neilenns/Collins-FMS-3000/reference.png

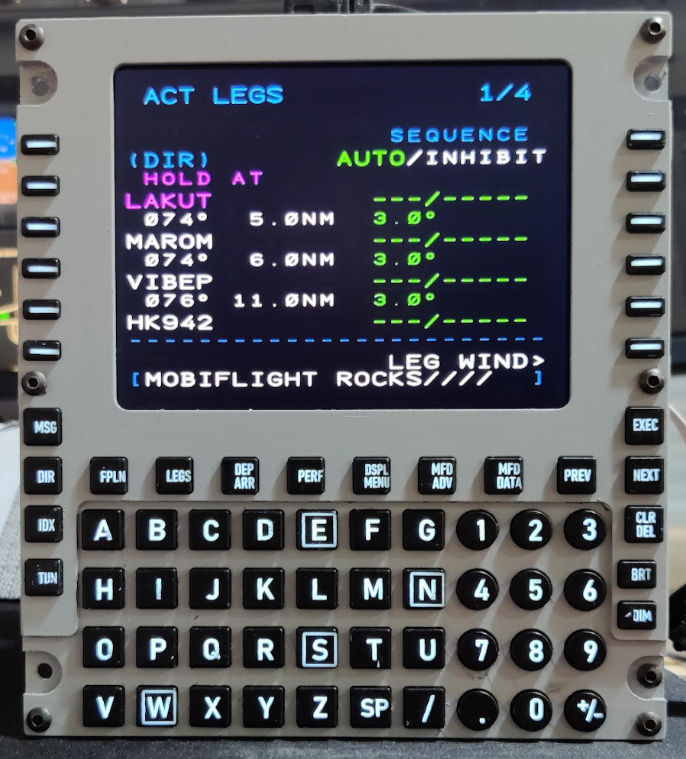
reference.png
