neilenns/Collins-FMS-3000/Sim reference.png

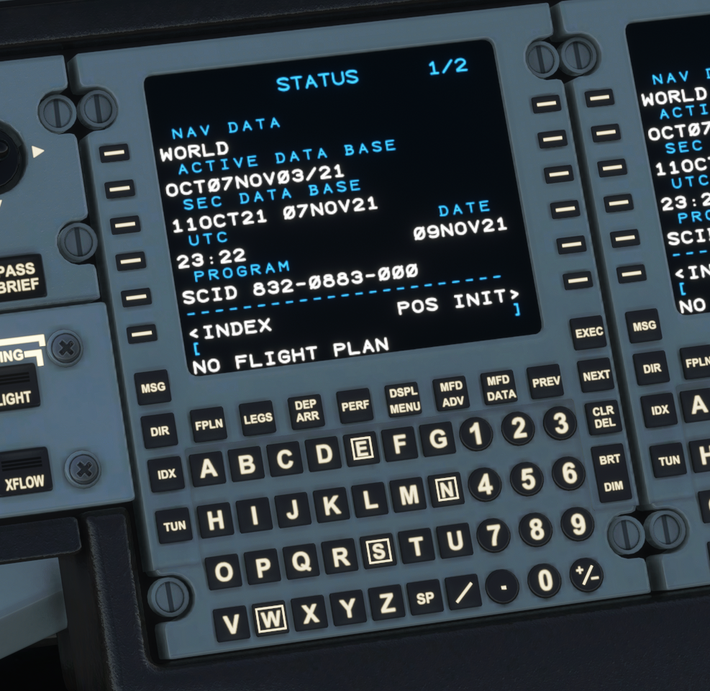
Sim reference.png
