neilenns/Collins-FMS-3000/README.md

# Collins-FMS-3000
PCB for a replica Collins FMS-3000 to use with MobiFlight
