neilenns/Collins-FMS-3000/3D Models/UE25BE5510H--3DModel-STEP-533217.STEP

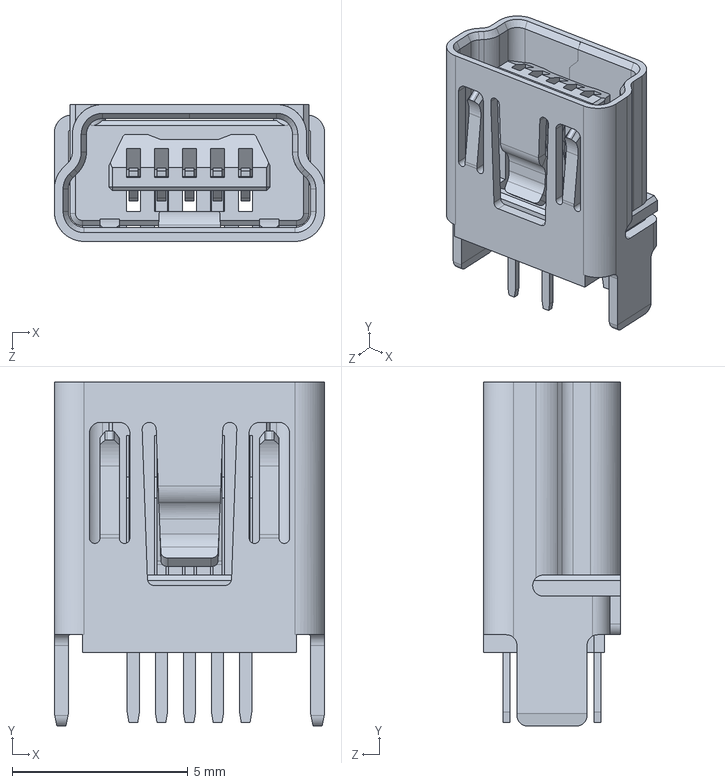
[picture p3: CAD file, 2022-11-02]
3D Models/UE25BE5510H--3DModel-STEP-533217.STEP
7.70 x 9.80 x 3.90 mm
