neilenns/Collins-FMS-3000/Key caps/Board mount bar.stl

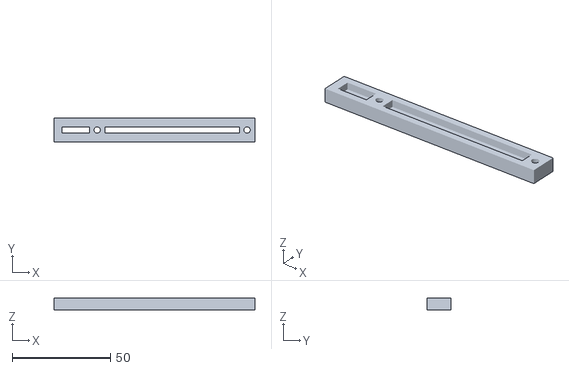
[picture p4: CAD file, 2022-12-11]
Key caps/Board mount bar.stl
102.1 x 12.0 x 6.00
