neilenns/Collins-FMS-3000/3D Models/6x6 LED button.step

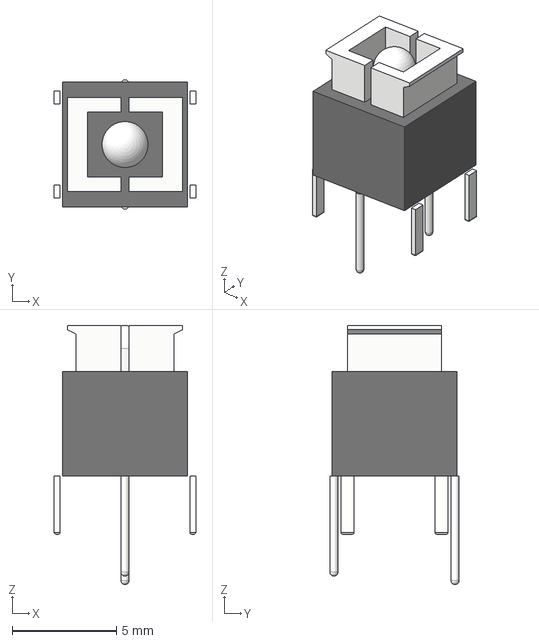
[picture p5: CAD file, 2022-11-02]
3D Models/6x6 LED button.step
6.78 x 6.20 x 12.4 mm
