neilenns/Collins-FMS-3000/Key caps/Screen frame.stl

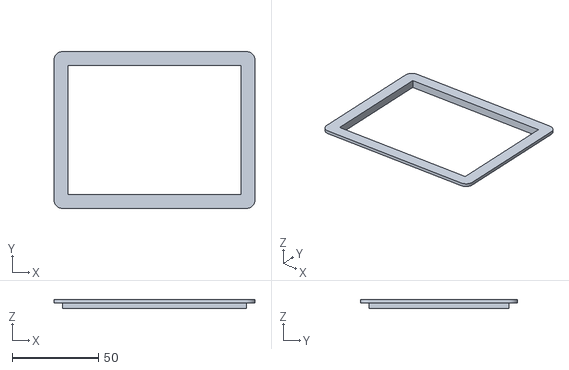
[picture p6: CAD file, 2022-12-11]
Key caps/Screen frame.stl
116.8 x 91.2 x 5.00
