neilenns/Collins-FMS-3000/Key caps/Panel.stl

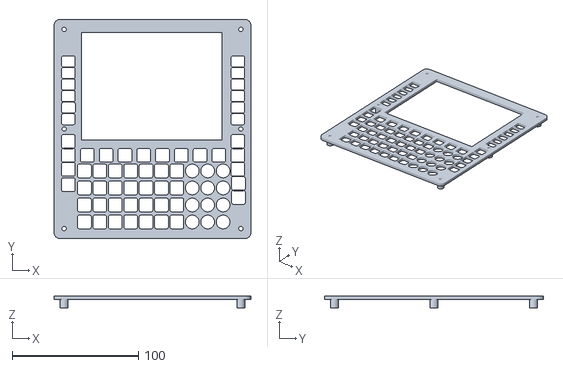
[picture p7: CAD file, 2022-12-11]
Key caps/Panel.stl
155.9 x 173.6 x 9.80
