neilenns/Collins-FMS-3000/Key caps/Board mount bracket.stl

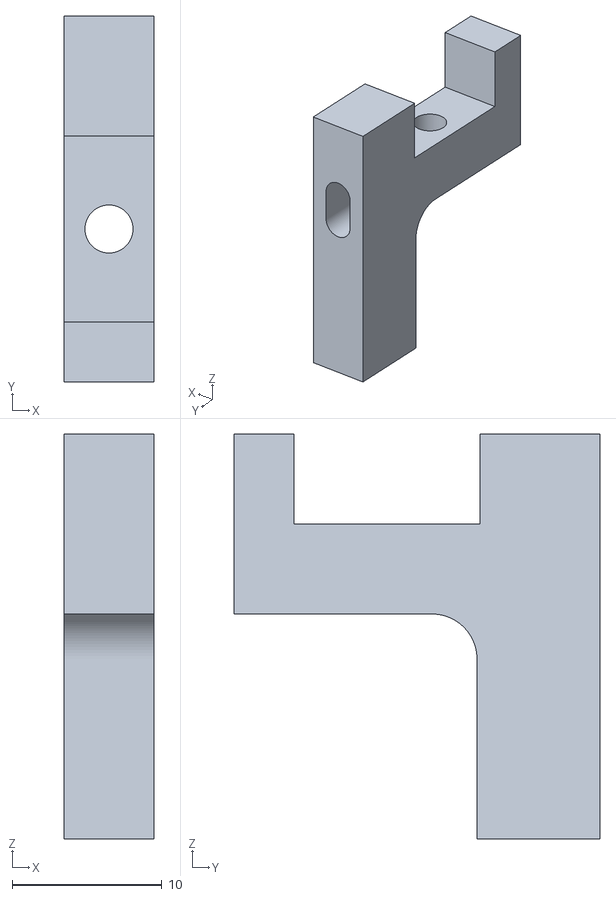
[picture p8: CAD file, 2022-12-11]
Key caps/Board mount bracket.stl
6.00 x 24.4 x 27.0
