neilenns/Collins-FMS-3000/Key caps/Blank round.stl

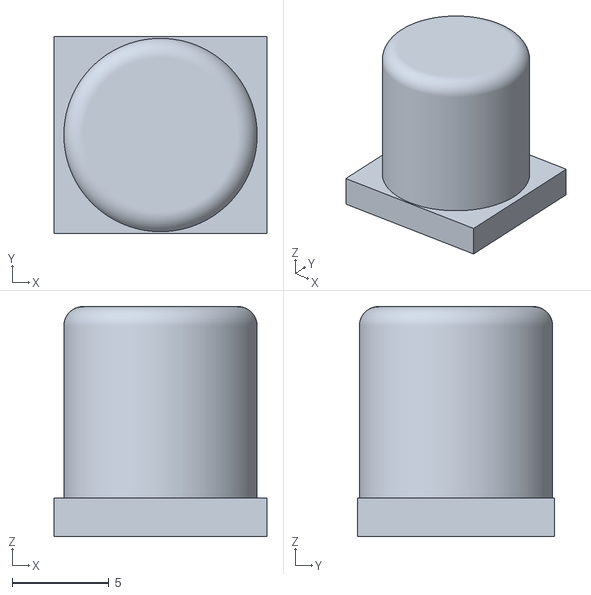
[picture p9: CAD file, 2022-11-27]
Key caps/Blank round.stl
11.0 x 10.2 x 11.9
