neilenns/Collins-FMS-3000/Key caps/Blank rectangle.stl

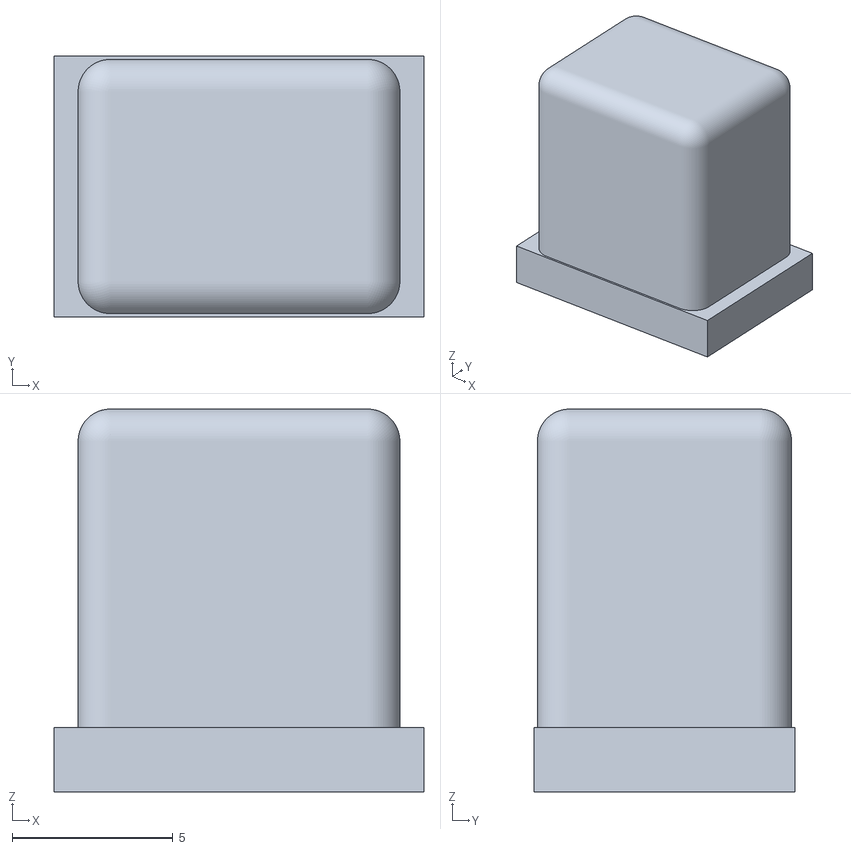
[picture p10: CAD file, 2022-11-27]
Key caps/Blank rectangle.stl
11.5 x 8.10 x 11.9
