neilenns/Collins-FMS-3000/Key caps/Blank square.stl

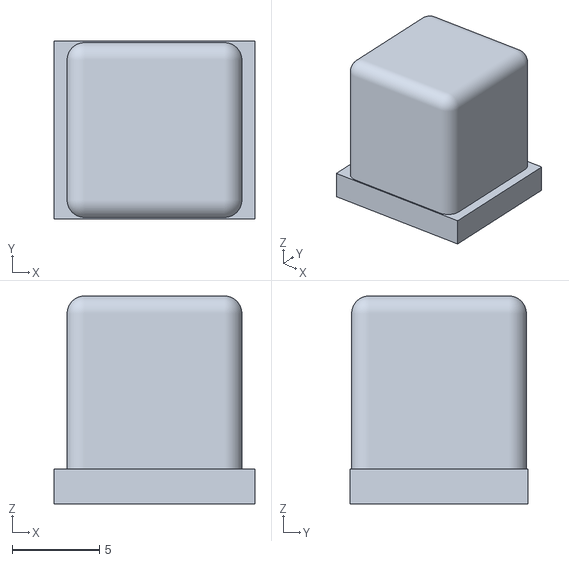
[picture p11: CAD file, 2022-11-27]
Key caps/Blank square.stl
11.5 x 10.2 x 11.9
