neilenns/Collins-FMS-3000/Collins-FMS-3000.kicad_pcb

## KiCad design Collins-FMS-3000.kicad_pcb (2023-01-21)

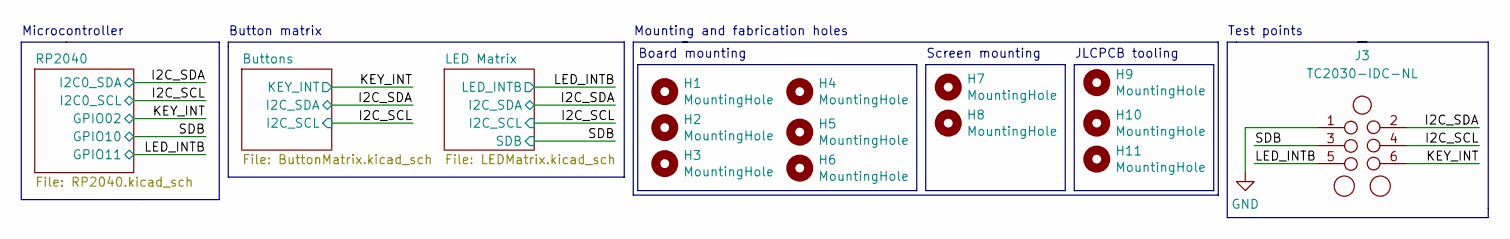
[picture p12: schematic Collins-FMS-3000.kicad_sch, Collins FMS 3000]

Parts:
H1, H2, H3, H4, H5, H6, H7, H8: MountingHole; MountingHole_3.2mm_M3
H9, H10, H11: MountingHole; JLCPCB_Tooling_Hole
J3: TC2030-IDC-NL; Tag-Connect_TC2030-IDC-NL_2x03_P1.27mm_Vertical

Connections:
/I2C_SCL: J3.4; also elsewhere on the board
/I2C_SDA: J3.2; also elsewhere on the board
/KEY_INT: J3.6; also elsewhere on the board
/LED_INTB: J3.5; also elsewhere on the board
/SDB: J3.3; also elsewhere on the board
GND: J3.1; also elsewhere on the board

Notes on the sheet:
Test points
Button matrix
Board mounting
Screen mounting
Microcontroller
Mounting and fabrication holes
JLCPCB tooling

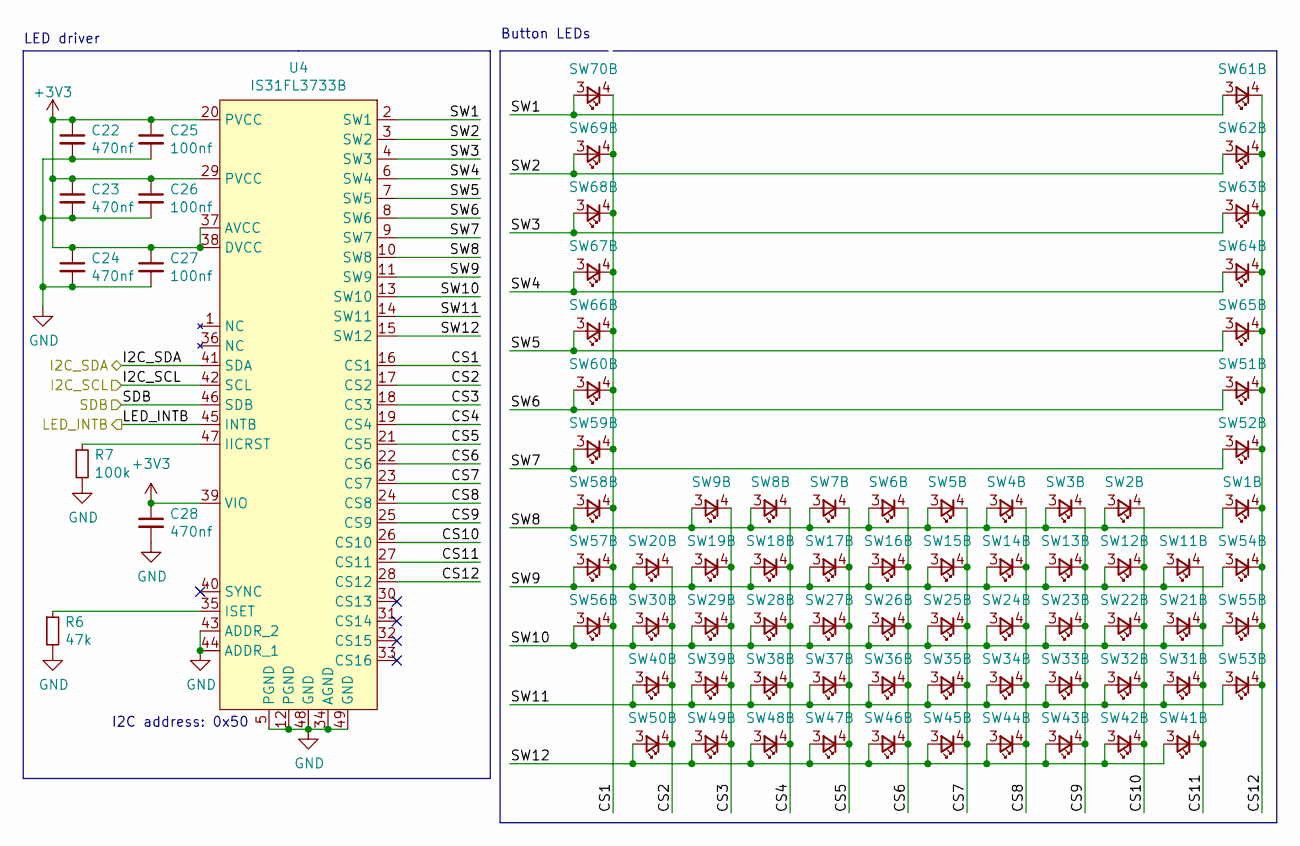
[picture p13: schematic LEDMatrix.kicad_sch, Collins FMS 3000]

Parts:
C22, C23, C24, C28: 470nf; Perfect_0402; MPN - JLCPCB C47339; JLC 0402
C25, C26, C27: 100nf; Perfect_0402; MPN - JLCPCB C1525; JLC 0402
R6: 47k; Perfect_0402; MPN - JLCPCB C25792; JLC 0402
R7: 100k; R_0603_1608Metric; MPN - JLCPCB C25803; JLC 0603
SW1, SW2, SW3, SW4, SW5, SW6, SW7, SW8, SW9, SW11, SW12, SW13, SW14, SW15, SW16, SW17, SW18, SW19, SW20, SW21, SW22, SW23, SW24, SW25, SW26, SW27, SW28, SW29, SW30, SW31, SW32, SW33, SW34, SW35, SW36, SW37, SW38, SW39, SW40, SW41, SW42, SW43, SW44, SW45, SW46, SW47, SW48, SW49, SW50, SW51, SW52, SW53, SW54, SW55, SW56, SW57, SW58, SW59, SW60, SW61, SW62, SW63, SW64, SW65, SW66, SW67, SW68, SW69, SW70: SW_Push_LED; SW_PUSH_LED_THT
U4: IS31FL3733B; TQFP-48-1EP_7x7mm_P0.5mm_EP5x5mm_ThermalVias

Connections:
+3V3: C22.1, C23.1, C24.1, C25.1, C26.1, C27.1, C28.1, U4.20 (PVCC), U4.29 (PVCC), U4.37 (AVCC), U4.38 (DVCC), U4.39 (VIO); also elsewhere on the board
/I2C_SCL: U4.42 (SCL); also elsewhere on the board
/I2C_SDA: U4.41 (SDA); also elsewhere on the board
/LED Matrix/CS1: SW56.4, SW57.4, SW58.4, SW59.4, SW60.4, SW66.4, SW67.4, SW68.4, SW69.4, SW70.4, U4.16 (CS1)
/LED Matrix/CS2: SW20.4, SW30.4, SW40.4, SW50.4, U4.17 (CS2)
/LED Matrix/CS3: SW9.4, SW19.4, SW29.4, SW39.4, SW49.4, U4.18 (CS3)
/LED Matrix/CS4: SW8.4, SW18.4, SW28.4, SW38.4, SW48.4, U4.19 (CS4)
/LED Matrix/CS5: SW7.4, SW17.4, SW27.4, SW37.4, SW47.4, U4.21 (CS5)
/LED Matrix/CS6: SW6.4, SW16.4, SW26.4, SW36.4, SW46.4, U4.22 (CS6)
/LED Matrix/CS7: SW5.4, SW15.4, SW25.4, SW35.4, SW45.4, U4.23 (CS7)
/LED Matrix/CS8: SW4.4, SW14.4, SW24.4, SW34.4, SW44.4, U4.24 (CS8)
/LED Matrix/CS9: SW3.4, SW13.4, SW23.4, SW33.4, SW43.4, U4.25 (CS9)
/LED Matrix/CS10: SW2.4, SW12.4, SW22.4, SW32.4, SW42.4, U4.26 (CS10)
/LED Matrix/CS11: SW11.4, SW21.4, SW31.4, SW41.4, U4.27 (CS11)
/LED Matrix/CS12: SW1.4, SW51.4, SW52.4, SW53.4, SW54.4, SW55.4, SW61.4, SW62.4, SW63.4, SW64.4, SW65.4, U4.28 (CS12)
/LED Matrix/SW1: SW61.3, SW70.3, U4.2 (SW1)
/LED Matrix/SW2: SW62.3, SW69.3, U4.3 (SW2)
/LED Matrix/SW3: SW63.3, SW68.3, U4.4 (SW3)
/LED Matrix/SW4: SW64.3, SW67.3, U4.6 (SW4)
/LED Matrix/SW5: SW65.3, SW66.3, U4.7 (SW5)
/LED Matrix/SW6: SW51.3, SW60.3, U4.8 (SW6)
/LED Matrix/SW7: SW52.3, SW59.3, U4.9 (SW7)
/LED Matrix/SW8: SW1.3, SW2.3, SW3.3, SW4.3, SW5.3, SW6.3, SW7.3, SW8.3, SW9.3, SW58.3, U4.10 (SW8)
/LED Matrix/SW9: SW11.3, SW12.3, SW13.3, SW14.3, SW15.3, SW16.3, SW17.3, SW18.3, SW19.3, SW20.3, SW54.3, SW57.3, U4.11 (SW9)
/LED Matrix/SW10: SW21.3, SW22.3, SW23.3, SW24.3, SW25.3, SW26.3, SW27.3, SW28.3, SW29.3, SW30.3, SW55.3, SW56.3, U4.13 (SW10)
/LED Matrix/SW11: SW31.3, SW32.3, SW33.3, SW34.3, SW35.3, SW36.3, SW37.3, SW38.3, SW39.3, SW40.3, SW53.3, U4.14 (SW11)
/LED Matrix/SW12: SW41.3, SW42.3, SW43.3, SW44.3, SW45.3, SW46.3, SW47.3, SW48.3, SW49.3, SW50.3, U4.15 (SW12)
/LED_INTB: U4.45 (INTB); also elsewhere on the board
/SDB: U4.46 (SDB); also elsewhere on the board
GND: C22.2, C23.2, C24.2, C25.2, C26.2, C27.2, C28.2, R6.2, R7.2, U4.5 (PGND), U4.12 (PGND), U4.34 (AGND), U4.43 (ADDR_2), U4.44 (ADDR_1), U4.48 (GND), U4.49 (GND); also elsewhere on the board
unnamed: R6.1, U4.35 (ISET)
unnamed: R7.1, U4.47 (IICRST)

Notes on the sheet:
LED driver
I2C address: 0x50
Button LEDs

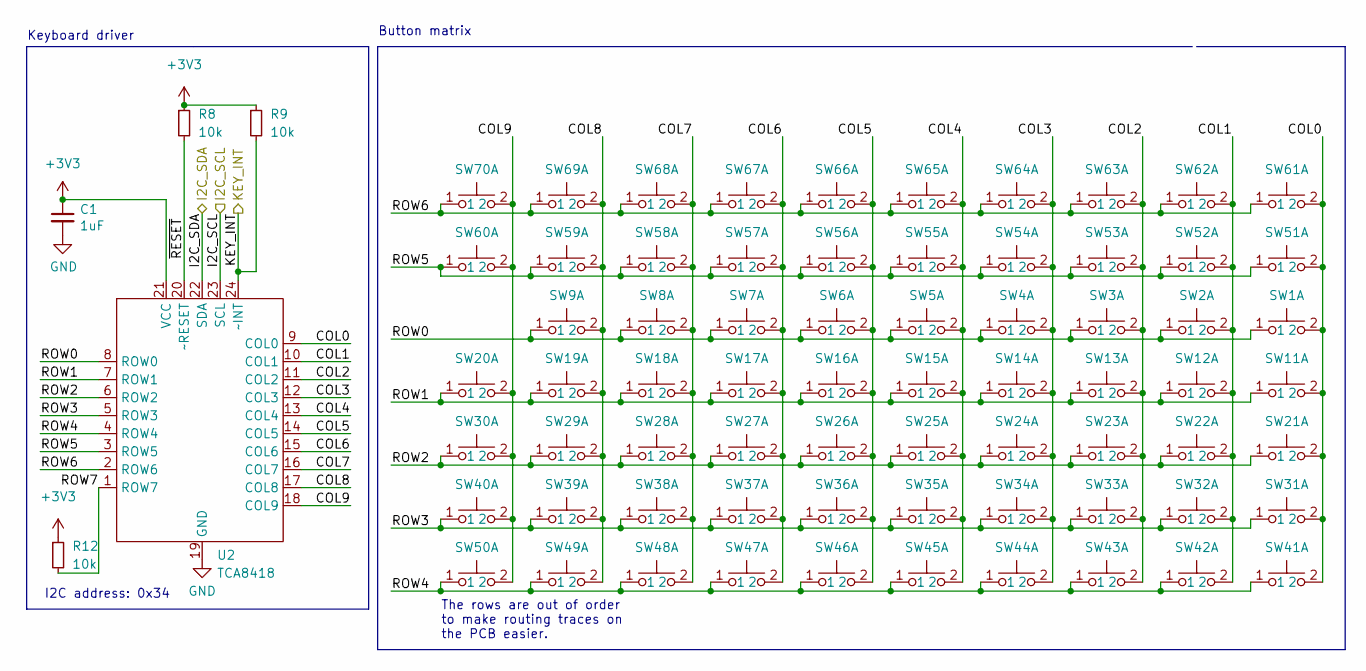
[picture p14: schematic ButtonMatrix.kicad_sch, Collins FMS 3000]

Parts:
C1: 1uF; Perfect_0402; MPN - JLCPCB C52923; JLC 0402
R8, R9, R12: 10k; Perfect_0402; MPN - JLCPCB C25744
SW1, SW2, SW3, SW4, SW5, SW6, SW7, SW8, SW9, SW11, SW12, SW13, SW14, SW15, SW16, SW17, SW18, SW19, SW20, SW21, SW22, SW23, SW24, SW25, SW26, SW27, SW28, SW29, SW30, SW31, SW32, SW33, SW34, SW35, SW36, SW37, SW38, SW39, SW40, SW41, SW42, SW43, SW44, SW45, SW46, SW47, SW48, SW49, SW50, SW51, SW52, SW53, SW54, SW55, SW56, SW57, SW58, SW59, SW60, SW61, SW62, SW63, SW64, SW65, SW66, SW67, SW68, SW69, SW70: SW_Push_LED; SW_PUSH_LED_THT
U2: TCA8418; WQFN-24-1EP_4x4mm_P0.5mm_EP2.6x2.6mm; MPN - JLCPCB C138713

Connections:
+3V3: C1.1, R8.1, R9.1, R12.1, U2.21 (VCC); also elsewhere on the board
/Buttons/COL0: SW1.2, SW11.2, SW21.2, SW31.2, SW41.2, SW51.2, SW61.2, U2.9 (COL0)
/Buttons/COL1: SW2.2, SW12.2, SW22.2, SW32.2, SW42.2, SW52.2, SW62.2, U2.10 (COL1)
/Buttons/COL2: SW3.2, SW13.2, SW23.2, SW33.2, SW43.2, SW53.2, SW63.2, U2.11 (COL2)
/Buttons/COL3: SW4.2, SW14.2, SW24.2, SW34.2, SW44.2, SW54.2, SW64.2, U2.12 (COL3)
/Buttons/COL4: SW5.2, SW15.2, SW25.2, SW35.2, SW45.2, SW55.2, SW65.2, U2.13 (COL4)
/Buttons/COL5: SW6.2, SW16.2, SW26.2, SW36.2, SW46.2, SW56.2, SW66.2, U2.14 (COL5)
/Buttons/COL6: SW7.2, SW17.2, SW27.2, SW37.2, SW47.2, SW57.2, SW67.2, U2.15 (COL6)
/Buttons/COL7: SW8.2, SW18.2, SW28.2, SW38.2, SW48.2, SW58.2, SW68.2, U2.16 (COL7)
/Buttons/COL8: SW9.2, SW19.2, SW29.2, SW39.2, SW49.2, SW59.2, SW69.2, U2.17 (COL8)
/Buttons/COL9: SW20.2, SW30.2, SW40.2, SW50.2, SW60.2, SW70.2, U2.18 (COL9)
/Buttons/ROW0: SW1.1, SW2.1, SW3.1, SW4.1, SW5.1, SW6.1, SW7.1, SW8.1, SW9.1, U2.8 (ROW0)
/Buttons/ROW1: SW11.1, SW12.1, SW13.1, SW14.1, SW15.1, SW16.1, SW17.1, SW18.1, SW19.1, SW20.1, U2.7 (ROW1)
/Buttons/ROW2: SW21.1, SW22.1, SW23.1, SW24.1, SW25.1, SW26.1, SW27.1, SW28.1, SW29.1, SW30.1, U2.6 (ROW2)
/Buttons/ROW3: SW31.1, SW32.1, SW33.1, SW34.1, SW35.1, SW36.1, SW37.1, SW38.1, SW39.1, SW40.1, U2.5 (ROW3)
/Buttons/ROW4: SW41.1, SW42.1, SW43.1, SW44.1, SW45.1, SW46.1, SW47.1, SW48.1, SW49.1, SW50.1, U2.4 (ROW4)
/Buttons/ROW5: SW51.1, SW52.1, SW53.1, SW54.1, SW55.1, SW56.1, SW57.1, SW58.1, SW59.1, SW60.1, U2.3 (ROW5)
/Buttons/ROW6: SW61.1, SW62.1, SW63.1, SW64.1, SW65.1, SW66.1, SW67.1, SW68.1, SW69.1, SW70.1, U2.2 (ROW6)
/Buttons/ROW7: R12.2, U2.1 (ROW7)
/Buttons/~RESET: R8.2, U2.20 (~RESET)
/I2C_SCL: U2.23 (SCL); also elsewhere on the board
/I2C_SDA: U2.22 (SDA); also elsewhere on the board
/KEY_INT: R9.2, U2.24 (~INT); also elsewhere on the board
GND: C1.2, U2.19 (GND); also elsewhere on the board

Notes on the sheet:
The rows are out of order to make routing traces on the PCB easier.
Button matrix
Keyboard driver
I2C address: 0x34

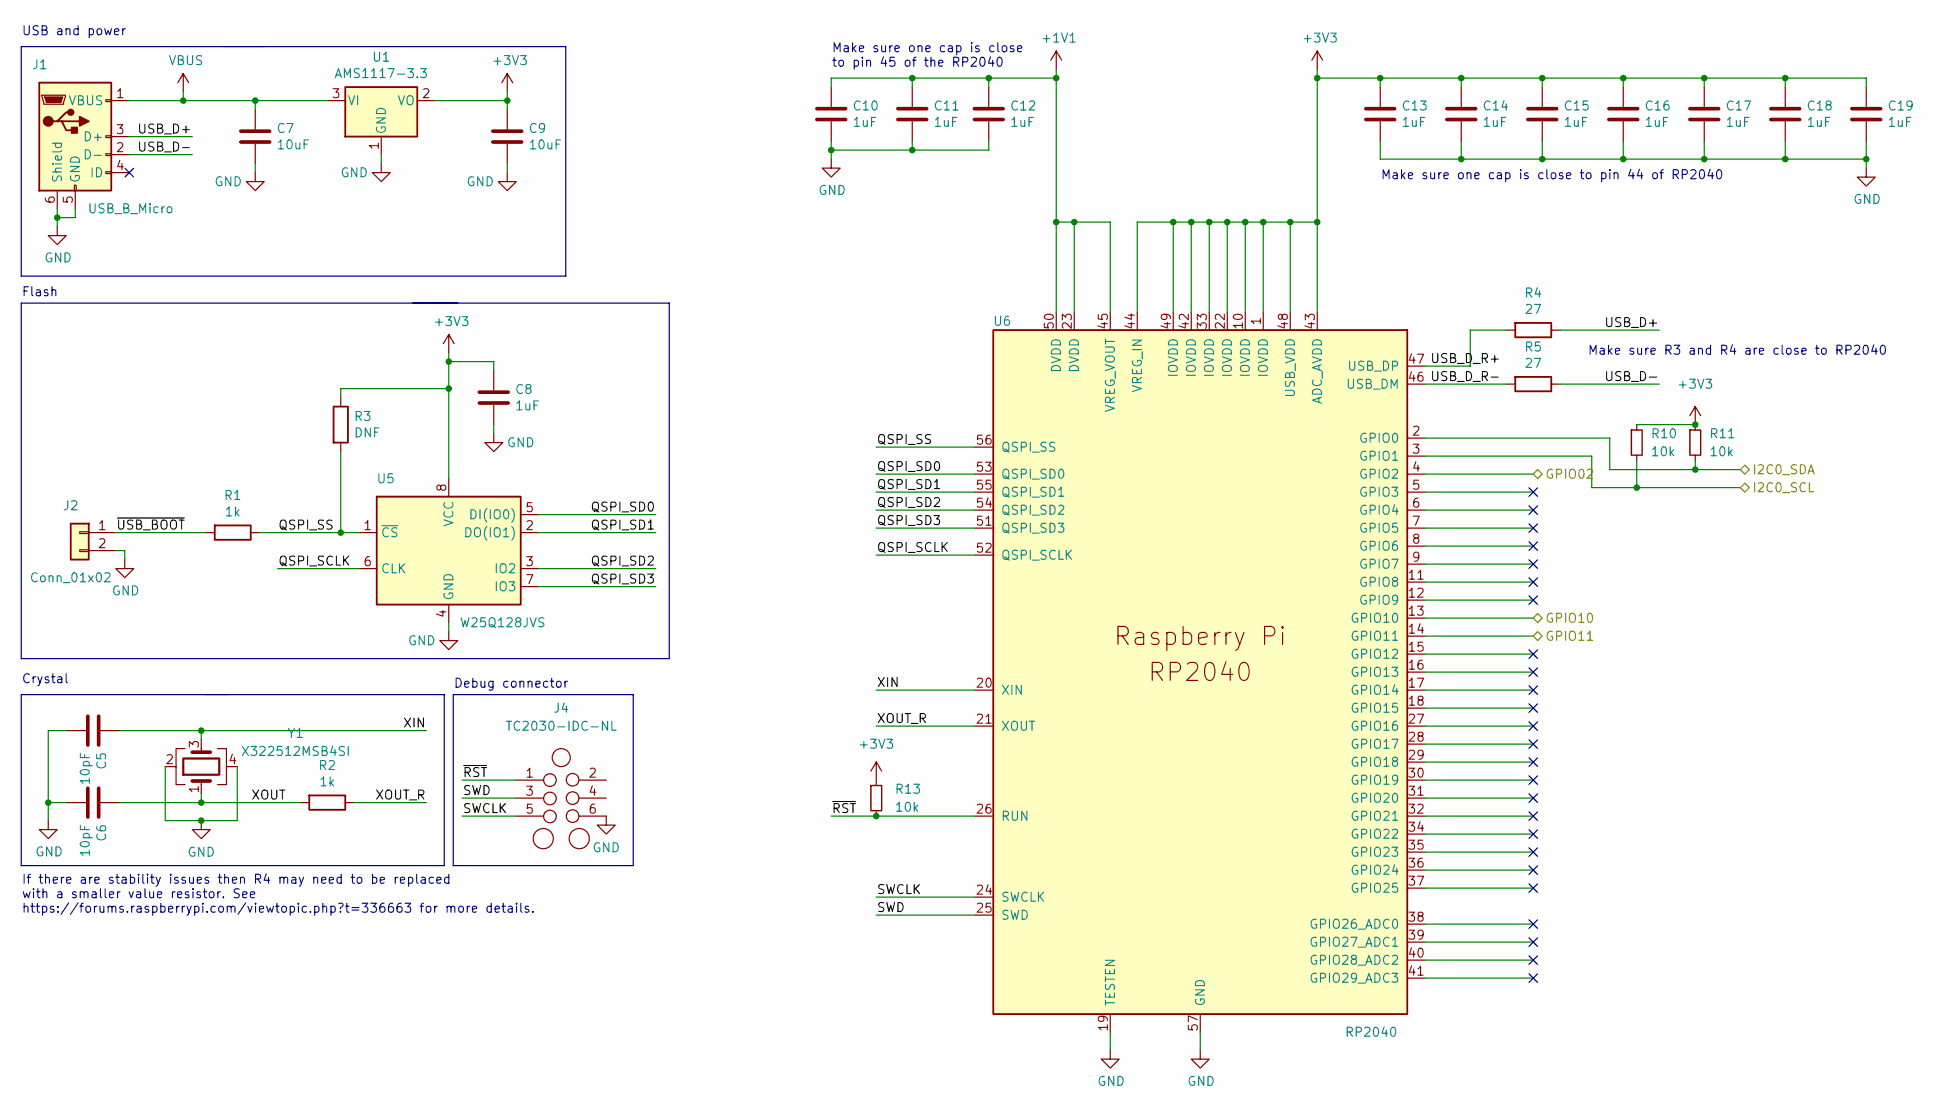
[picture p15: schematic RP2040.kicad_sch, Collins FMS 3000]

Parts:
C5, C6: 10pF; Perfect_0402; MPN - JLCPCB C32949; JLC 0402
C7, C9: 10uF; C_0603_1608Metric; MPN - JLCPCB C19702; JLC 0603
C8, C10, C11, C12, C13, C14, C15, C16, C17, C18, C19: 1uF; Perfect_0402; MPN - JLCPCB C52923; JLC 0402
J1: USB_B_Micro; USB_B_Mini_Amphenol_UE25BE5510H
J2: Conn_01x02; PinHeader_1x02_P2.54mm_Vertical
J4: TC2030-IDC-NL; Tag-Connect_TC2030-IDC-NL_2x03_P1.27mm_Vertical
R1, R2: 1k; Perfect_0402; MPN - JLCPCB C11702; JLC 0402
R3: DNF; R_1206_3216Metric_Pad1.30x1.75mm_HandSolder
R4, R5: 27; R_0603_1608Metric; MPN - JLCPCB C25190; JLC 0603
R10, R11: 10k; R_1206_3216Metric_Pad1.30x1.75mm_HandSolder; MPN - JLCPCB C17902
R13: 10k; Perfect_0402; MPN - JLCPCB C25744
U1: AMS1117-3.3; SOT-223-3_TabPin2; MPN - JLCPCB C6186; JLC SOT-223
U5: W25Q128JVS; SOIC-8_5.23x5.23mm_P1.27mm; MPN - JLCPCB C97521; JLC SOIC-8_5.3x5.3x1.27P
U6: RP2040; QFN56P40_700X700X90L40X18T310N; MPN - JLCPCB C2040; JLC LQFN-56_EP_7.0x7.0x0.4P
Y1: X322512MSB4SI; Crystal_SMD_3225-4Pin_3.2x2.5mm; MPN - JLCPCB C9002; JLC SMD-3225_4P

Connections:
+1V1: C10.1, C11.1, C12.1, U6.23 (DVDD), U6.45 (VREG_VOUT), U6.50 (DVDD)
+3V3: C8.1, C9.1, C13.1, C14.1, C15.1, C16.1, C17.1, C18.1, C19.1, R3.1, R10.1, R11.1, R13.1, U1.2 (VO), U5.8 (VCC), U6.1 (IOVDD), U6.10 (IOVDD), U6.22 (IOVDD), U6.33 (IOVDD), U6.42 (IOVDD), U6.43 (ADC_AVDD), U6.44 (VREG_IN), U6.48 (USB_VDD), U6.49 (IOVDD); also elsewhere on the board
/I2C_SCL: R10.2, U6.3 (GPIO1); also elsewhere on the board
/I2C_SDA: R11.2, U6.2 (GPIO0); also elsewhere on the board
/KEY_INT: U6.4 (GPIO2); also elsewhere on the board
/LED_INTB: U6.14 (GPIO11); also elsewhere on the board
/RP2040/QSPI_SCLK: U5.6 (CLK), U6.52 (QSPI_SCLK)
/RP2040/QSPI_SD0: U5.5 (DI(IO0)), U6.53 (QSPI_SD0)
/RP2040/QSPI_SD1: U5.2 (DO(IO1)), U6.55 (QSPI_SD1)
/RP2040/QSPI_SD2: U5.3 (IO2), U6.54 (QSPI_SD2)
/RP2040/QSPI_SD3: U5.7 (IO3), U6.51 (QSPI_SD3)
/RP2040/QSPI_SS: R1.1, R3.2, U5.1 (~CS), U6.56 (QSPI_SS)
/RP2040/SWCLK: J4.5, U6.24 (SWCLK)
/RP2040/SWD: J4.3, U6.25 (SWD)
/RP2040/USB_D+: J1.3 (D+), R4.1
/RP2040/USB_D-: J1.2 (D-), R5.1
/RP2040/USB_D_R+: R4.2, U6.47 (USB_DP)
/RP2040/USB_D_R-: R5.2, U6.46 (USB_DM)
/RP2040/XIN: C5.1, U6.20 (XIN), Y1.3
/RP2040/XOUT: C6.1, R2.2, Y1.1
/RP2040/XOUT_R: R2.1, U6.21 (XOUT)
/RP2040/~RST: J4.1, R13.2, U6.26 (RUN)
/RP2040/~USB_BOOT: J2.1, R1.2
/SDB: U6.13 (GPIO10); also elsewhere on the board
GND: C5.2, C6.2, C7.2, C8.2, C9.2, C10.2, C11.2, C12.2, C13.2, C14.2, C15.2, C16.2, C17.2, C18.2, C19.2, J1.5 (GND), J1.6 (Shield), J2.2, J4.6, U1.1 (GND), U5.4 (GND), U6.19 (TESTEN), U6.57 (GND), Y1.2, Y1.4; also elsewhere on the board
VBUS: C7.1, J1.1 (VBUS), U1.3 (VI)

Notes on the sheet:
USB and power
Crystal
Debug connector
Flash
If there are stability issues then R4 may need to be replaced with a smaller value resistor. See https://forums.raspberrypi.com/viewtopic.php?t=336663 for more details.
Make sure one cap is close to pin 45 of the RP2040
Make sure one cap is close to pin 44 of RP2040
Make sure R3 and R4 are close to RP2040

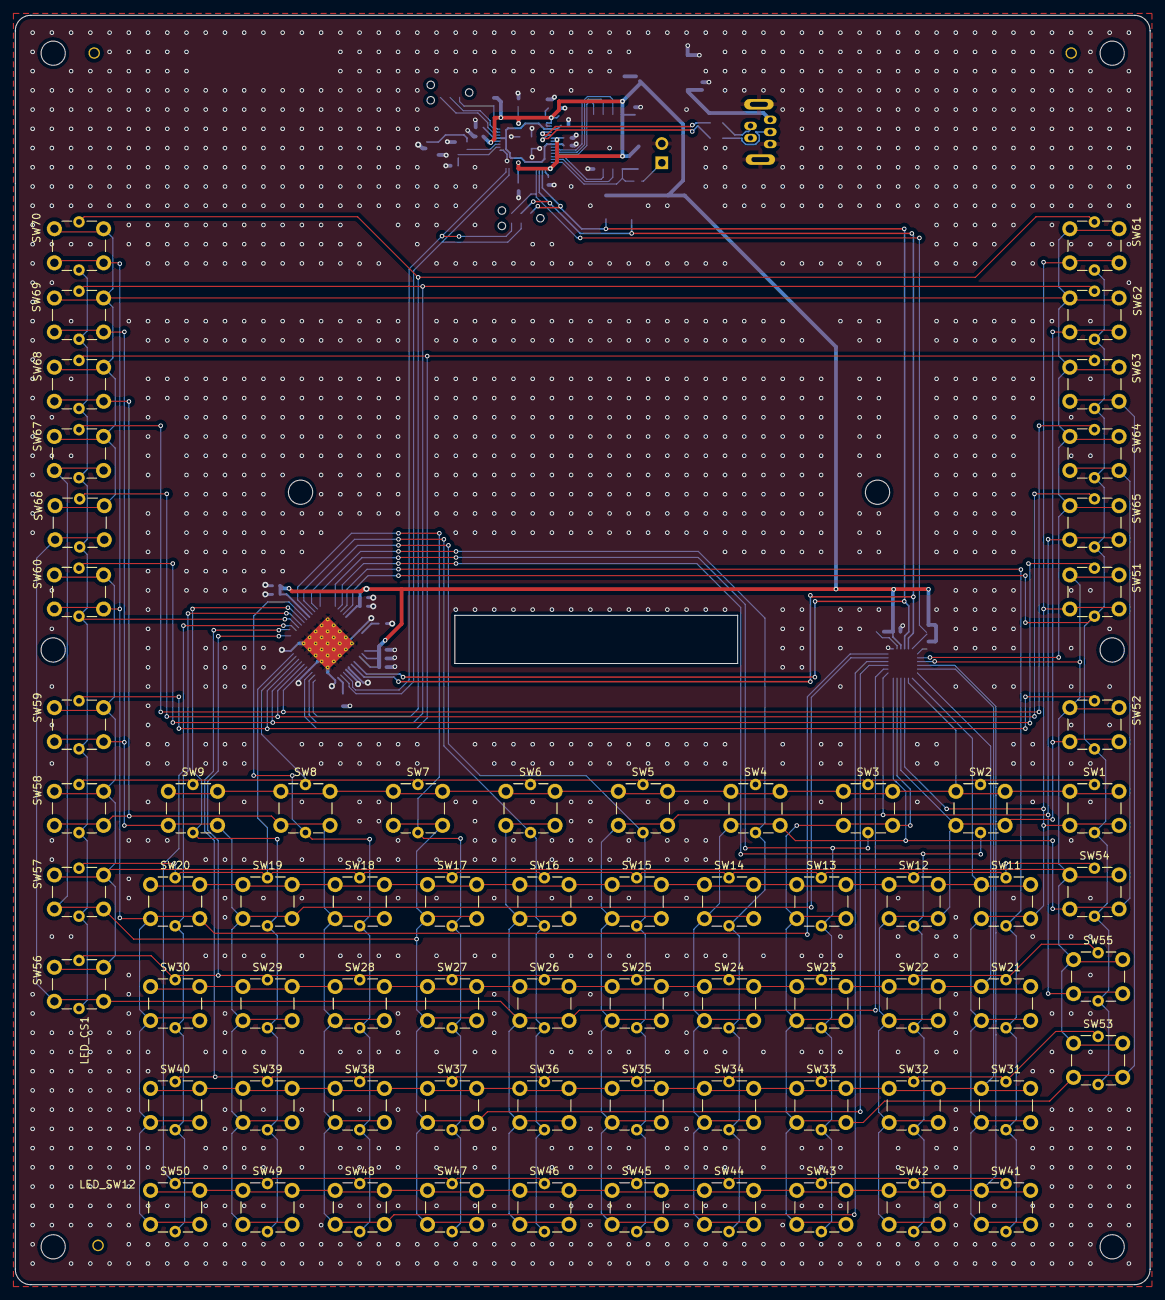
[picture p16: board Collins-FMS-3000.kicad_pcb from above]

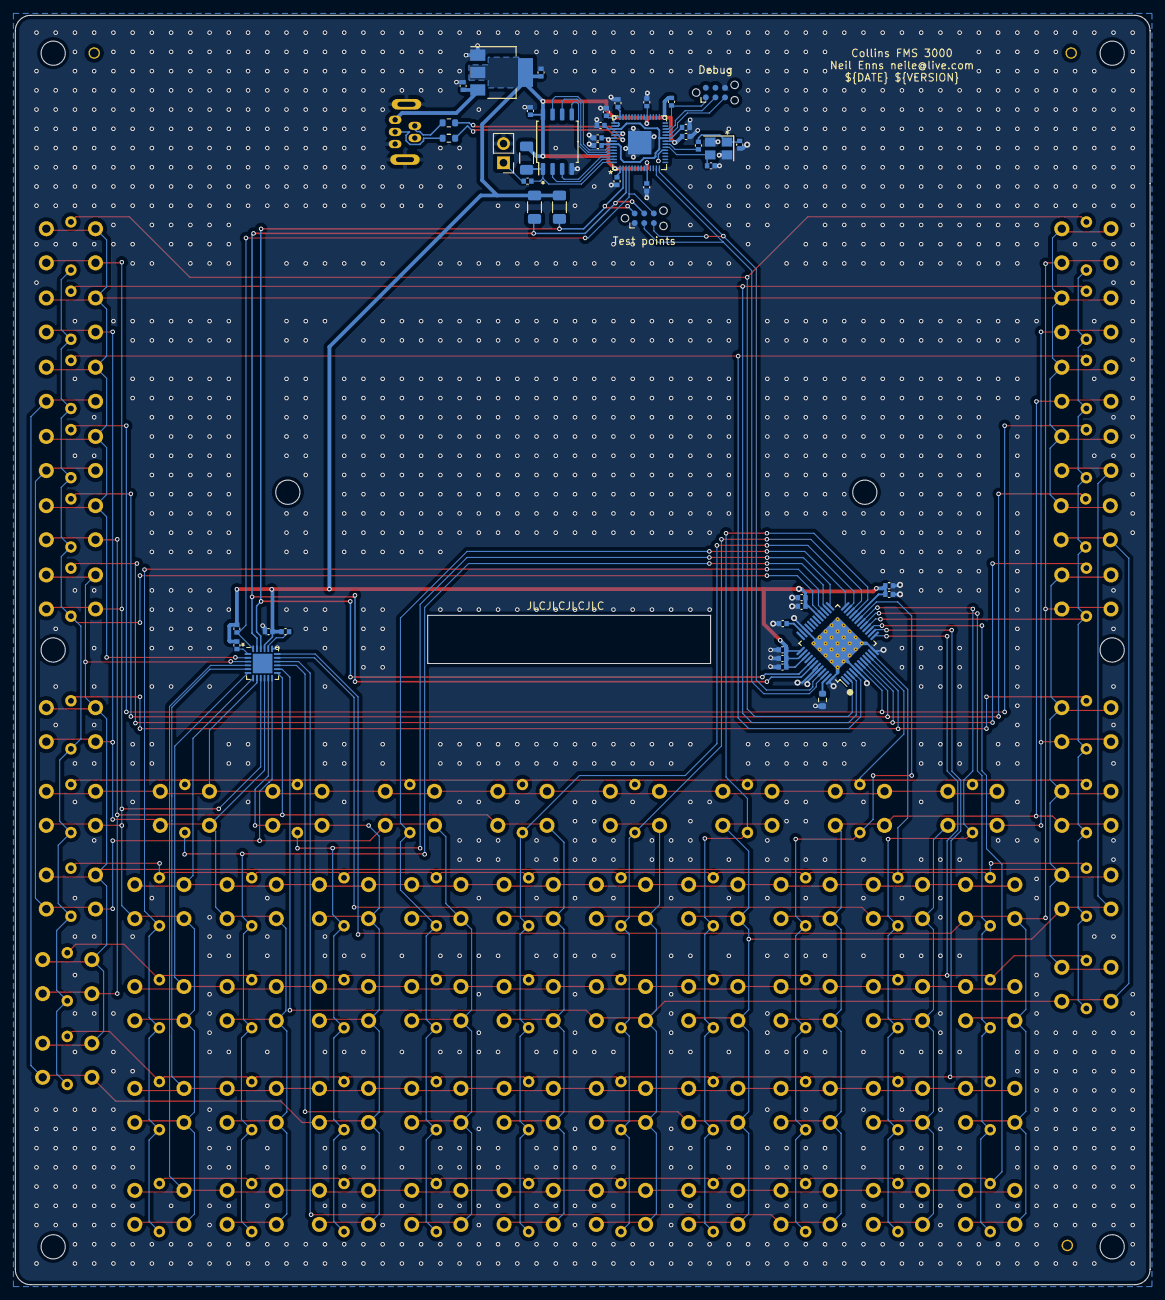
[picture p17: board Collins-FMS-3000.kicad_pcb from below]

Board: 2 copper layers, 149.9 x 167.6 mm, 126 parts (46 on the bottom side), 71 nets.
