neilenns/Collins-FMS-3000/(threads)

Thread 1 (2021-11-28):

Make SWy traces wider

neilenns, 2021-11-28:
Per spec sheet on page 25:

> The CSx pins maximum current is 42mA (RISET = 20k) and the SWy pins maximum current is 672mA (RISET = 20k), the width of the trace SWy should have wider trace than CSx.

neilenns, 2021-11-30:
Did the math and this isn't required.

Closed 2021-11-30.

Thread 6 (2021-12-01):

Resistors are missing on the LED rows

neilenns, 2021-12-01:

neilenns, 2021-12-05:
This isn't a thing. They were on the key rows not the LED rows

Closed 2021-12-05.

Thread 14 (2021-12-18):

Remove row pull-up resistors

neilenns, 2021-12-18:
The ones JLCPCB installed didn't seem to work and the onboard ones in the MCP23017 work fine. Remove them from the schematic and the board, and rip up the big +5V trace that is no longer needed.

neilenns, 2022-01-11:
Nah, just put it to the right JLCPCB part number (a 2k2 resistor instead of a 2.2 resistor).

Closed 2022-01-11.

Thread 15 (2021-12-18):

Fix incorrect part number for LED resistor

neilenns, 2021-12-18:
The LCSC part number for the resistor that goes in front of the power LED is wrong. Correct it.

Closed 2022-01-11.

Thread 16 (2022-01-06):

Correct part number for 2.2k resistors

neilenns, 2022-01-06:
The JLCPCB part number used was for 2.2 ohm resistors not 2.2k. Oops.

neilenns, 2022-11-02:
This is fixed, I just deleted them.

Closed 2022-11-02.

Thread 22 (2022-11-10):

Enlarge cutout for display cable

neilenns, 2022-11-10:
Needs to be wider

neilenns, 2022-11-11:
Made it as big as I can without a massive redesign

Closed 2022-11-11.
