neilenns/Collins-FMS-3000/(commit log)

2021-11-03 Add KiCad gitignore
2021-11-03 Empty KiCad project
    [Collins-FMS-3000.kicad_pcb, Collins-FMS-3000.sch]
2021-11-03 Initial button layout with IO expanders
    [Collins-FMS-3000.sch]
2021-11-03 Change I2C address, add capacitors
    [Collins-FMS-3000.sch]
2021-11-04 New component and key matrix done
    [Collins-FMS-3000.sch]
2021-11-04 Schematic works
    [Collins-FMS-3000.sch]
2021-11-08 Actual button matrix with sub sheets
    [ButtonMatrix.sch, Collins-FMS-3000.sch]
2021-11-08 Add a generic PCB design so kibot runs
    [Collins-FMS-3000.kicad_pcb]
2021-11-08 Update variable placeholders
    [ButtonMatrix.sch, Collins-FMS-3000.sch]
2021-11-08 Add LED driver chip
    [ButtonMatrix.sch, Collins-FMS-3000.sch]
2021-11-08 Add LED driver and led matrix
    [ButtonMatrix.sch, Collins-FMS-3000.sch, LEDMatrix.sch]
2021-11-09 Add ATmega32u4 to board
    [ATmega32u4.sch, ButtonMatrix.sch, Collins-FMS-3000.kicad_pcb, Collins-FMS-3000.sch, LEDMatrix.sch]
2021-11-09 Redo the LED matrix
    [ATmega32u4.sch, Collins-FMS-3000.sch, LEDMatrix.sch]
2021-11-09 Much PCB layout
    [ATmega32u4.sch, Collins-FMS-3000.kicad_pcb, Collins-FMS-3000.sch]
2021-11-09 Lots of PCB layout
    [ATmega32u4.sch, Collins-FMS-3000.kicad_pcb, Collins-FMS-3000.sch, LEDMatrix.sch]
2021-11-10 Add footprint for IS31FL3733B
    [Collins-FMS-3000.kicad_pcb]
2021-11-10 New LED chip, tons of routing on the board
    [ATmega32u4.sch, Collins-FMS-3000.kicad_pcb, Collins-FMS-3000.sch, LEDMatrix.sch]
2021-11-10 Tons of PCB routing
    [Collins-FMS-3000.kicad_pcb]
2021-11-10 More routing
    [ATmega32u4.sch, Collins-FMS-3000.kicad_pcb, Collins-FMS-3000.sch]
2021-11-11 Fully routed
    [ATmega32u4.sch, Collins-FMS-3000.kicad_pcb, Collins-FMS-3000.sch]
2021-11-11 Fix some silkscreen
    [Collins-FMS-3000.kicad_pcb]
2021-11-11 Add mounting holes and silkscreen
    [Collins-FMS-3000.kicad_pcb, Collins-FMS-3000.sch]
2021-11-11 Assign JLCPCB part numbers
    [ATmega32u4.sch, ButtonMatrix.sch, Collins-FMS-3000.sch]
2021-11-11 Fix the button layout. Still needs trace work.
    [ButtonMatrix.sch, Collins-FMS-3000.kicad_pcb, Collins-FMS-3000.sch, LEDMatrix.sch]
2021-11-11 Round edges, clean up traces, add placement marks
    [Collins-FMS-3000.kicad_pcb, Collins-FMS-3000.sch]
2021-11-15 Add INTB connection
    [ATmega32u4.sch, Collins-FMS-3000.kicad_pcb, Collins-FMS-3000.sch]
2021-11-18 Remove diodes, update interrupt connections
    [ATmega32u4.sch, ButtonMatrix.sch, Collins-FMS-3000.kicad_pcb, Collins-FMS-3000.sch]
2021-11-20 Connect unused pins
    [Collins-FMS-3000.kicad_pcb, Collins-FMS-3000.sch]
2021-11-20 Get rid of interrupt pullups, add row pullups
    [ButtonMatrix.sch, Collins-FMS-3000.kicad_pcb, Collins-FMS-3000.sch]
2021-11-20 Attempt to fix two kibot bugs
    [Collins-FMS-3000.kicad_pcb]
2021-11-20 Continue on error and upload pcb file for inspection
2021-11-20 Try PCB date replacement again
2021-11-23 Add ROW INTB, new debug header
    [ATmega32u4.sch, Collins-FMS-3000.kicad_pcb, Collins-FMS-3000.sch]
2021-11-28 Change ISET to 47k Fixes #3
    [Collins-FMS-3000.kicad_pcb, Collins-FMS-3000.sch]
2021-11-28 Connect thermal pad to ground pins (#5)
    [Collins-FMS-3000.kicad_pcb, Collins-FMS-3000.sch]
2021-12-01 Fix pad clearence DRC errors
    [Collins-FMS-3000.kicad_pcb]
2021-12-01 Use perfect 0402 pad dimensions
    [ATmega32u4.sch, ButtonMatrix.sch, Collins-FMS-3000.kicad_pcb, Collins-FMS-3000.sch]
2021-12-05 New PCB size and hole placement
    [Collins-FMS-3000.kicad_pcb, Collins-FMS-3000.sch]
2021-12-05 All buttons placed
    [Collins-FMS-3000.kicad_pcb]
2021-12-05 All buttons moved to new layout
    [ATmega32u4.sch, Collins-FMS-3000.kicad_pcb, Collins-FMS-3000.sch]
2021-12-05 More trace routing
    [ATmega32u4.sch, Collins-FMS-3000.kicad_pcb, Collins-FMS-3000.sch]
2021-12-06 MCPs are routed!
    [Collins-FMS-3000.kicad_pcb]
2021-12-06 Fully routed and passes DRC!
    [Collins-FMS-3000.kicad_pcb]
2021-12-06 Fix some bugs, add silkscreen
    [Collins-FMS-3000.kicad_pcb]
2021-12-06 Update components to match JLCPCB availability
    [ATmega32u4.sch, ButtonMatrix.sch, Collins-FMS-3000.kicad_pcb, Collins-FMS-3000.sch]
2021-12-07 Add via stitching
    [Collins-FMS-3000.kicad_pcb]
2021-12-07 Fix JLCPCB part number for R28
    [ATmega32u4.sch]
2021-12-08 Minor schematic adjustment to clarify capacitor positions (#8)
    [Collins-FMS-3000.kicad_pcb, Collins-FMS-3000.sch]
2021-12-08 Fix too close via DRC errors (#12)
    [Collins-FMS-3000.kicad_pcb]
2021-12-08 Add keystone test points (#13)
    [Collins-FMS-3000.kicad_pcb, Collins-FMS-3000.sch]
2022-01-11 Add version and date to PCB file (#18)
2022-01-11 Fix pull-up resistor value (#19)
    [ButtonMatrix.sch]
2022-01-11 Add keycaps
    [A.stl, B.stl, BRT.stl, C.stl, CLR DEL.stl, D.stl, DEP ARR.stl, DIM.stl]
2022-01-11 Schematic update
    [Collins-FMS-3000.sch]
2022-11-02 Switch to RP2040 instead of atmega32u4 (#21)
    * First pass trying to get the Pico done, plus obviously button caps
    * Passes design rule checks
    * Remove v5 files
    [0.stl, 1.stl, 2.stl, 3 digit 7 segment display v3.f3d, 3.stl, 4.stl, 5.stl, 6.stl]
2022-11-02 Fix placement of PCB version number
    [Collins-FMS-3000.kicad_pcb]
2022-11-02 Update silk screen to clarify pin 1 location on ICs
    [Collins-FMS-3000.kicad_pcb]
2022-11-02 Correct pin assignment for I2C, add via stitching
    [Collins-FMS-3000.kicad_sch, RP2040.kicad_sch]
2022-11-02 Update button placement, board size, silkscreen, models
    [6x6 LED button.step, UE25BE5510H--3DModel-STEP-533217.STEP]
2022-11-02 JLCPCB rotation cleanup, kibot script fixes
    [ButtonMatrix.kicad_sch, Collins-FMS-3000.kicad_pcb, Collins-FMS-3000.kicad_sch, LEDMatrix.kicad_sch, RP2040.kicad_sch]
2022-11-02 Fix version and date stamping
    [ButtonMatrix.kicad_sch, Collins-FMS-3000.kicad_pcb, Collins-FMS-3000.kicad_sch, LEDMatrix.kicad_sch, RP2040.kicad_sch]
2022-11-04 Switch to common component library USB connector
    [Collins-FMS-3000.kicad_pcb]
2022-11-04 Switch to new KiCad6 text variables for date and version
    [ButtonMatrix.kicad_sch, Collins-FMS-3000.kicad_pcb, Collins-FMS-3000.kicad_sch, LEDMatrix.kicad_sch, RP2040.kicad_sch]
2022-11-04 Replace 6x6 buttons with common repo version
2022-11-11 Make a larger cutout for the display cable, add button cap designs
    [Blank rectangle.stl, Blank square.stl, Rectangle button cap.stl, Round blank cap.stl, Square blank cap.stl]
2022-11-11 Add test points
    [Collins-FMS-3000.kicad_sch]
2022-11-12 Update button caps
    [0.stl, 1.stl, 2.stl, 3 digit 7 segment display v3.f3d, 3.stl, 4.stl, 5.stl, 6.stl]
2022-11-27 Final key caps
    [Blank rectangle.stl, Blank round.stl, Blank square - narrow.stl, Blank square.stl, Rectangle button cap.stl, Round blank cap.stl, Square blank cap.stl]
2022-12-11 Fix misaligned footprint
    [Board mount bar.stl, Board mount bracket.stl, Panel.stl, Screen frame.stl]
2023-01-06 Keyboard driver (#25)
    * Lots of pre-work before replacing RP2040 layout
    * New RP2040 layout added
    * FULLY ROUTED
    * Clean up schematic
    * More trace cleanup
    * Final trace cleanup
    [ATmega32u4.kicad_sch, ATmega32u4.sch, ButtonMatrix.kicad_sch, Collins-FMS-3000.kicad_sch, LEDMatrix.kicad_sch, RP2040.kicad_sch]
2023-01-06 Add pin 1 indicator for keyboard driver
    [Collins-FMS-3000.kicad_pcb]
2023-01-06 Fix silkscreen, add via stitching
    [Collins-FMS-3000.kicad_pcb]
2023-01-06 Re-do vias, a bit less heavy this time.
    [Collins-FMS-3000.kicad_pcb]
2023-01-06 Redo the stitching again
    [Collins-FMS-3000.kicad_pcb]
2023-01-06 Clean up the schematic
    [LEDMatrix.kicad_sch]
2023-01-06 Renumber buttons to match key array position (#26)
    [ButtonMatrix.kicad_sch, Collins-FMS-3000.kicad_pcb, Collins-FMS-3000.kicad_sch, LEDMatrix.kicad_sch]
2023-01-06 Add debug connector (#27)
    [Collins-FMS-3000.kicad_pcb, Collins-FMS-3000.kicad_sch, RP2040.kicad_sch]
2023-01-07 Fix exposed pad warning
    [ButtonMatrix.kicad_sch, Collins-FMS-3000.kicad_pcb]
2023-01-21 Add via stitching (#29)
    [Collins-FMS-3000.kicad_pcb]
